MultiX0/ip-nas/case/print_package/01_PRINT_FILES_STL/NAS_v6d_C_crown.stl

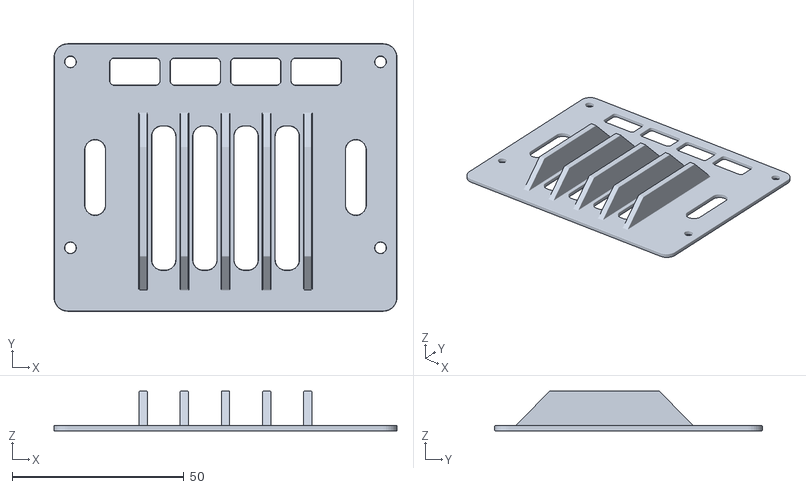
[picture p4: CAD file, 2026-10-22]
case/print_package/01_PRINT_FILES_STL/NAS_v6d_C_crown.stl
100.0 x 78.0 x 11.6
