MultiX0/ip-nas/case/print_package/01_PRINT_FILES_STL/NAS_v6d_plate_Bambu_X1C_PLA.3mf

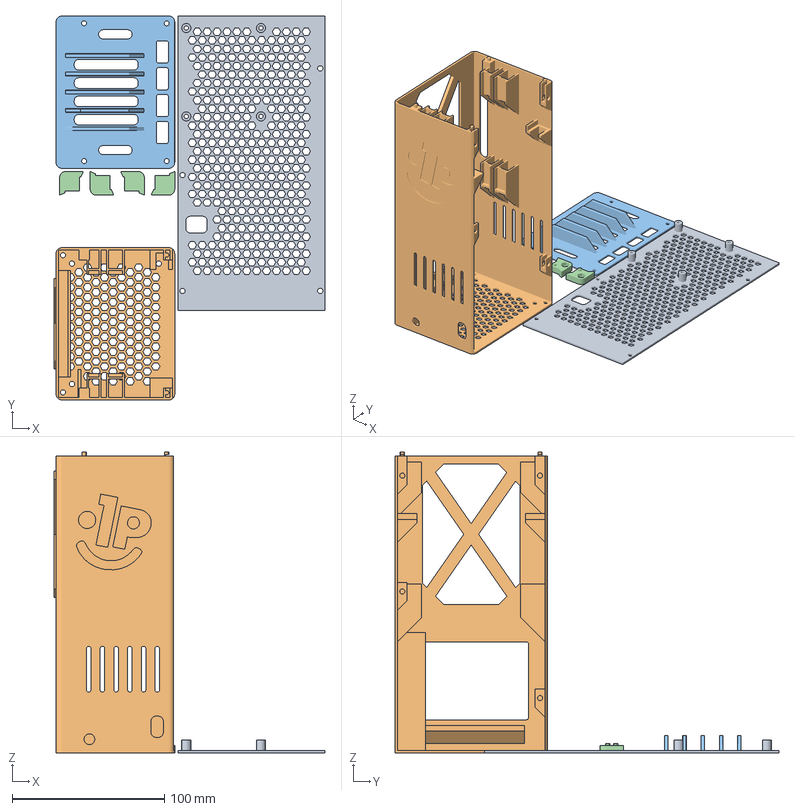
[picture p5: CAD file, 2026-10-22]
case/print_package/01_PRINT_FILES_STL/NAS_v6d_plate_Bambu_X1C_PLA.3mf
177.7 x 252.0 x 197.5 mm
NAS_v6d_B_back_door.stl
NAS_v6d_A_body.stl
NAS_v6d_C_crown.stl
NAS_v6d_D_legs_x4.stl
