MultiX0/ip-nas/case/print_package/01_PRINT_FILES_STL/NAS_v6d_A_body.stl

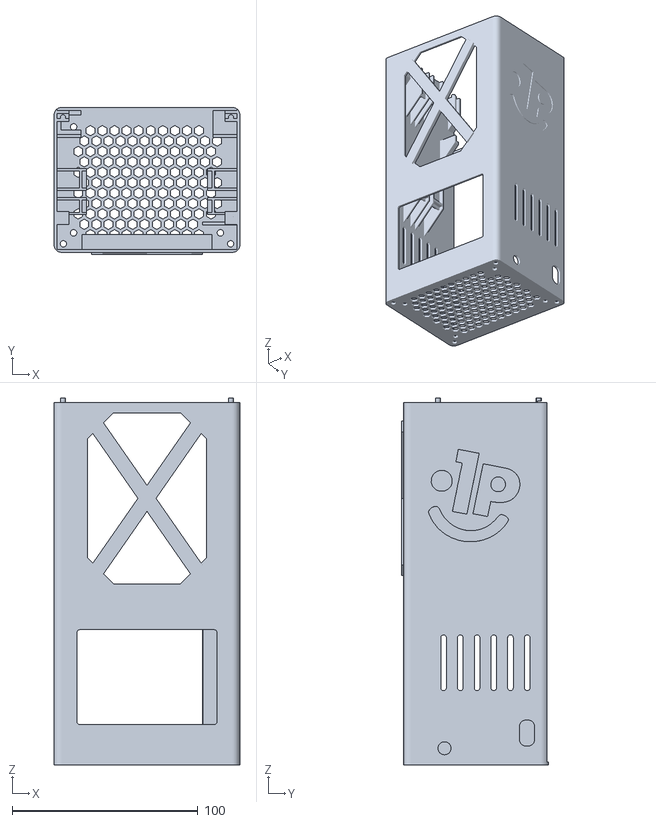
[picture p6: CAD file, 2026-10-22]
case/print_package/01_PRINT_FILES_STL/NAS_v6d_A_body.stl
100.0 x 79.2 x 197.5
