MultiX0/ip-nas/case/print_package/01_PRINT_FILES_STL/NAS_v6d_D_legs_x4.stl

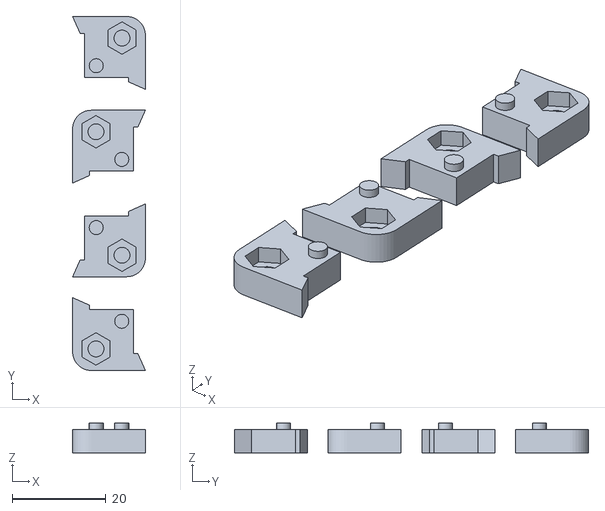
[picture p7: CAD file, 2026-10-22]
case/print_package/01_PRINT_FILES_STL/NAS_v6d_D_legs_x4.stl
15.6 x 75.6 x 6.30
