MultiX0/ip-nas/case/verification/prusaslicer_settings.txt

--layer-height 0.2 --first-layer-height 0.2 --perimeters 4 --top-solid-layers 5 --bottom-solid-layers 5 --fill-density 15% --fill-pattern gyroid --nozzle-diameter 0.4 --filament-diameter 1.75 --filament-density 1.24 --filament-cost 120 --temperature 220 --bed-temperature 60 --bed-shape 0x0,256x0,256x256,0x256 --max-print-height 256 --skirts 0 --no-support-material --center 128,128 --gcode-flavor marlin2 --perimeter-speed 200 --external-perimeter-speed 150 --small-perimeter-speed 100 --infill-speed 250 --solid-infill-speed 200 --top-solid-infill-speed 120 --bridge-speed 50 --gap-fill-speed 100 --travel-speed 400 --first-layer-speed 50 --default-acceleration 5000 --perimeter-acceleration 5000 --infill-acceleration 8000 --travel-acceleration 10000 --machine-max-acceleration-extruding 20000 --machine-max-acceleration-travel 20000 --machine-max-acceleration-x 20000 --machine-max-acceleration-y 20000 --machine-max-feedrate-x 500 --machine-max-feedrate-y 500 --max-volumetric-speed 21
